earthlcd/Pi-RAQ/SolidWorks/MTL-15001-02-OSH.SLDPRT

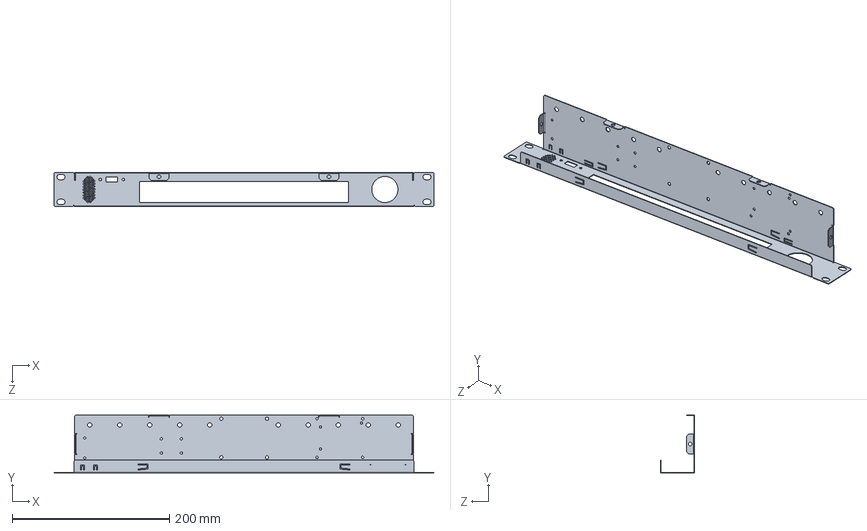
[picture p1: CAD file, 2015-07-02]
SolidWorks/MTL-15001-02-OSH.SLDPRT
482.6 x 73.7 x 43.7 mm
