earthlcd/Pi-RAQ/SolidWorks/MTL-15003-02-OSH.SLDPRT

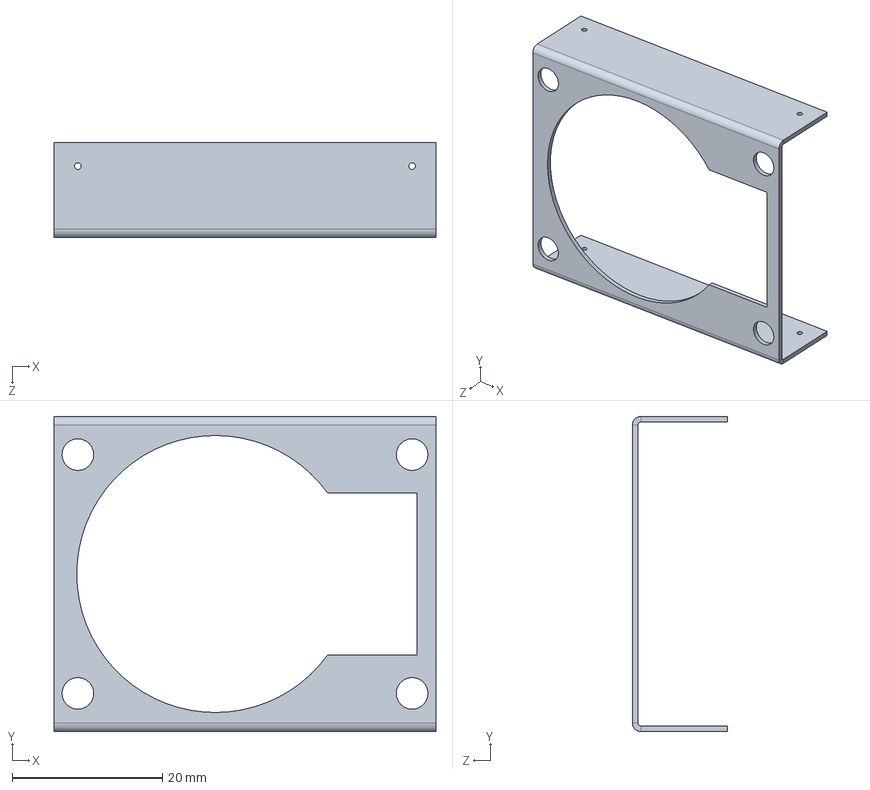
[picture p2: CAD file, 2015-07-02]
SolidWorks/MTL-15003-02-OSH.SLDPRT
50.8 x 41.9 x 12.7 mm
