earthlcd/Pi-RAQ/Altium/Schematic Prints.pdf

# LCD CONNECTOR

B0-7

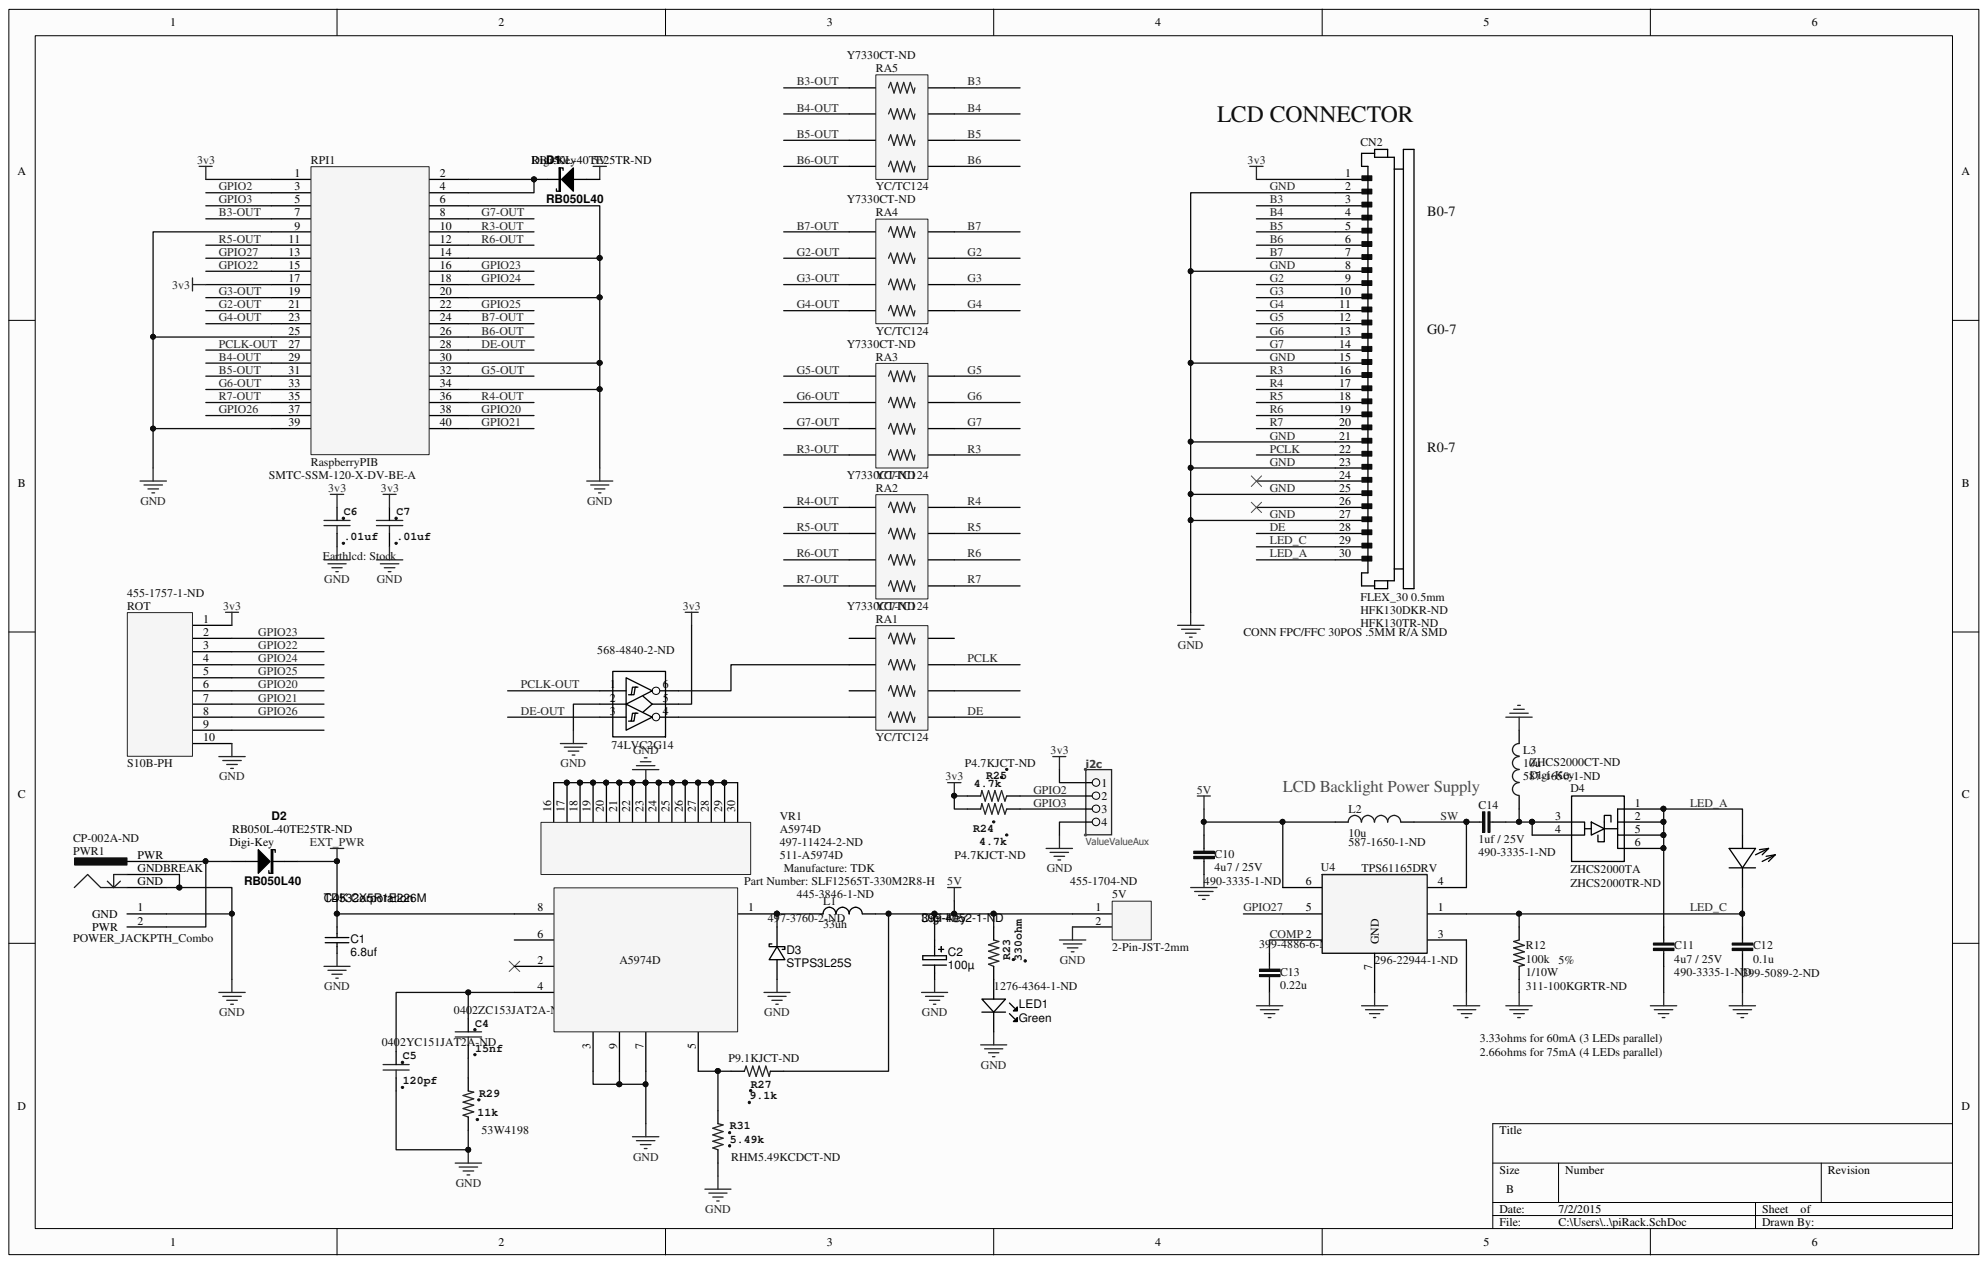
[picture p3: page 1]

SMTC-SSM-120-X-DV-BE-A

CONN FPC/FFC 30POS .5MM R/A SMD

LCD Backlight Power Supply
