earthlcd/Pi-RAQ/SolidWorks/MTL-15001-02-OSH.PDF

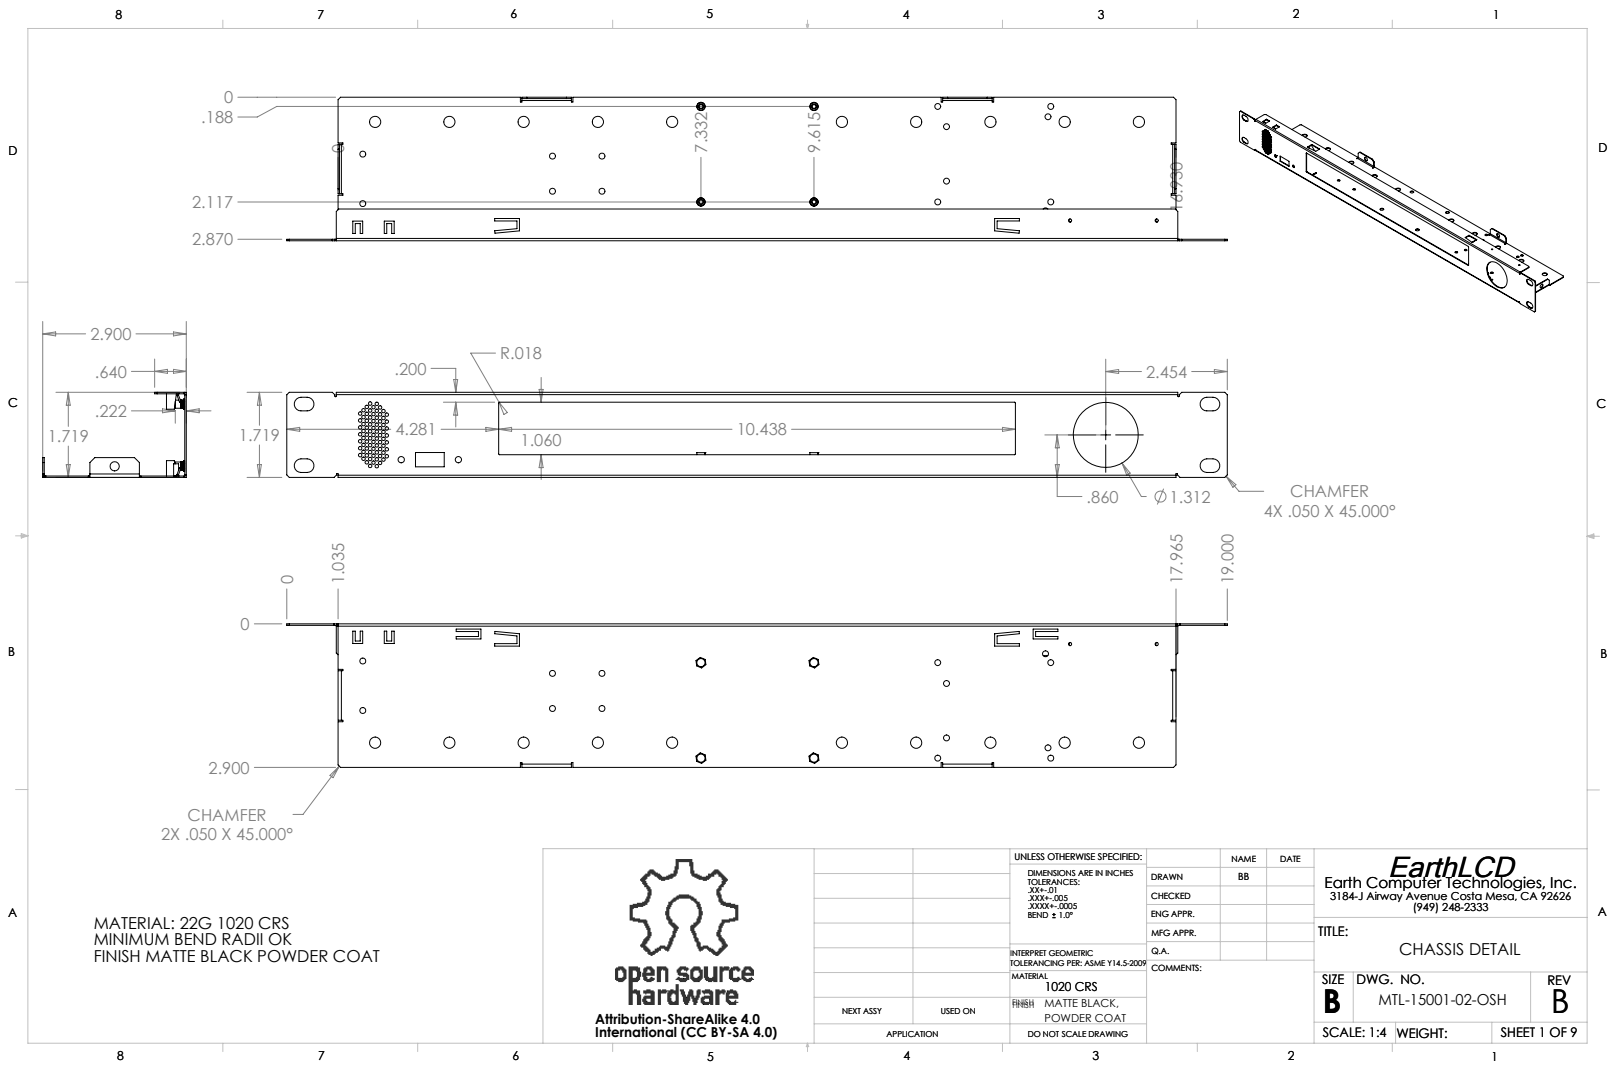
[picture p10: page 1]
FINISH MATTE BLACK POWDER COAT; CHASSIS DETAIL; NEXT ASSY; USED ON; ENG APPR.; MFG APPR.; DWG. NO.; REV; SCALE: 1:4 WEIGHT:; DO NOT SCALE DRAWING; SHEET 1 OF 9

EarthLCD
Earth Computer Technologies, Inc.
3184-J Airway Avenue Costa Mesa, CA 92626
TITLE:
MTL-15001-02-OSH

UNLESS OTHERWISE SPECIFIED:
DIMENSIONS ARE IN INCHES
TOLERANCES:
.XXX+-.005
.XXXX+-.0005
BEND 1.0°

MATERIAL: 22G 1020 CRS
MINIMUM BEND RADII OK

INTERPRET GEOMETRIC
TOLERANCING PER: ASME Y14.5-2009
MATERIAL
1020 CRS
MATTE BLACK,
FINISH
POWDER COAT
DO NOT SCALE DRAWING

Attribution-ShareAlike 4.0
International (CC BY-SA 4.0)

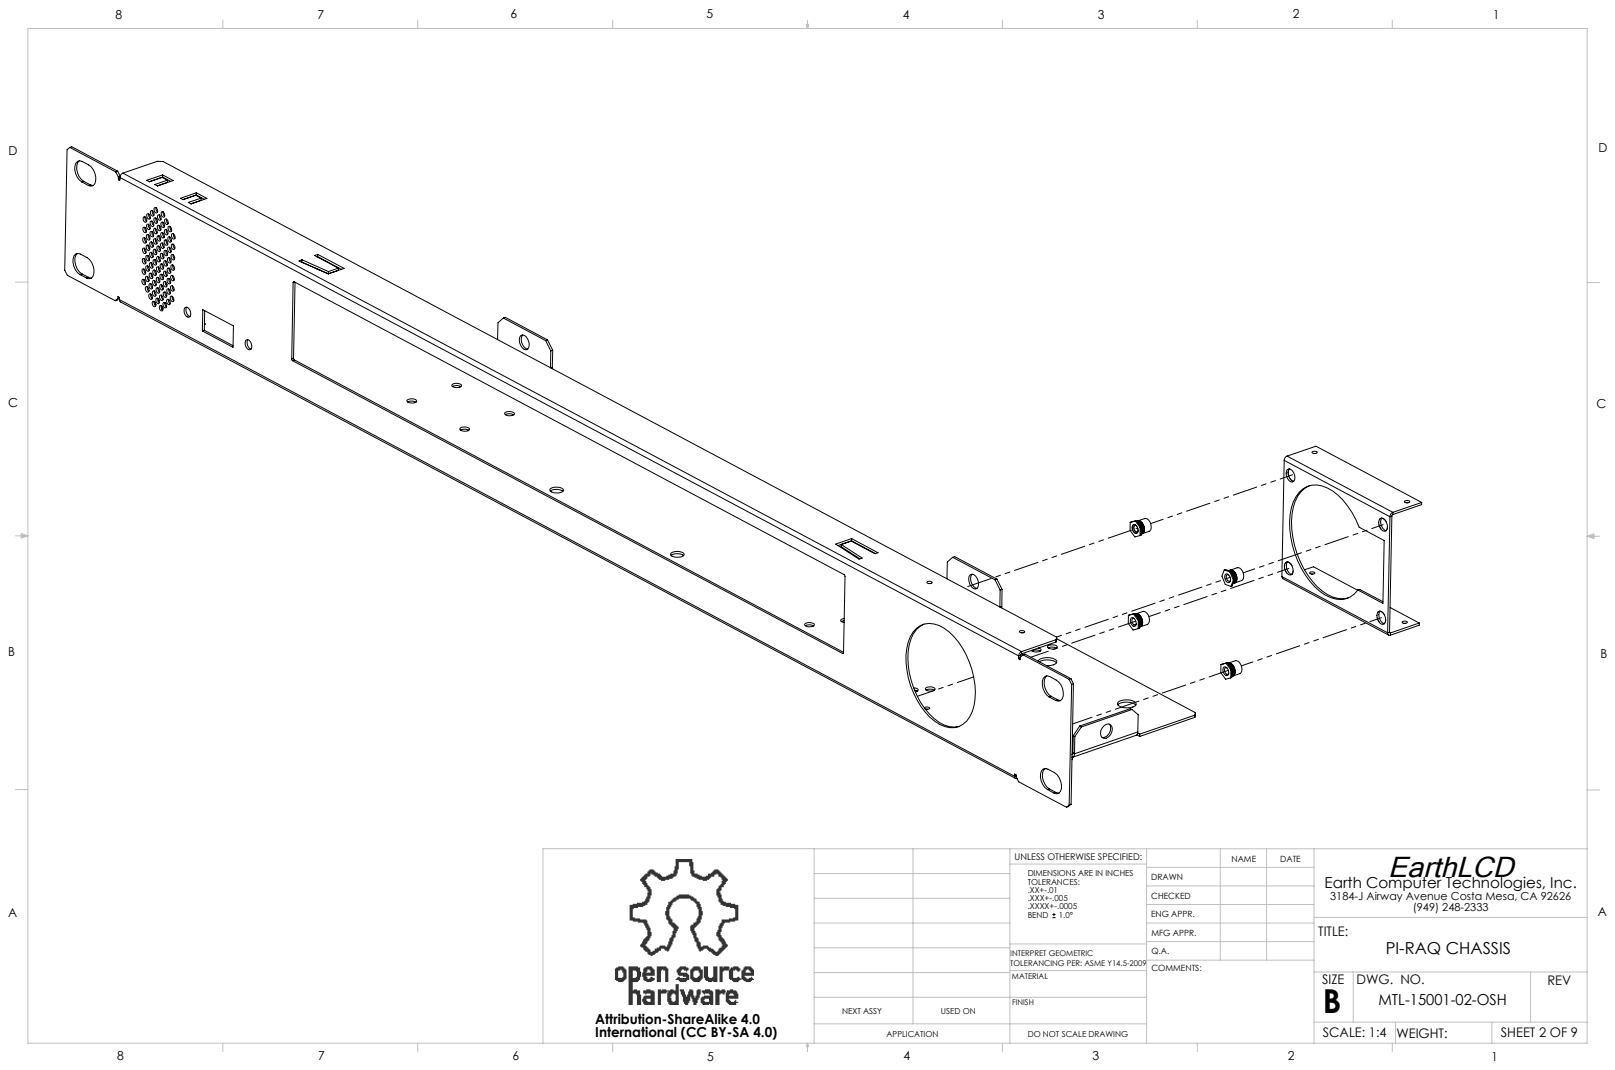
[picture p11: page 2]
ENG APPR.; MFG APPR.; DWG. NO.; REV

EarthLCD
Earth Computer Technologies, Inc.
3184-J Airway Avenue Costa Mesa, CA 92626
TITLE:
PI-RAQ CHASSIS

UNLESS OTHERWISE SPECIFIED:
DIMENSIONS ARE IN INCHES
TOLERANCES:
.XXX+-.005
.XXXX+-.0005
BEND 1.0°

INTERPRET GEOMETRIC
TOLERANCING PER: ASME Y14.5-2009
MATERIAL

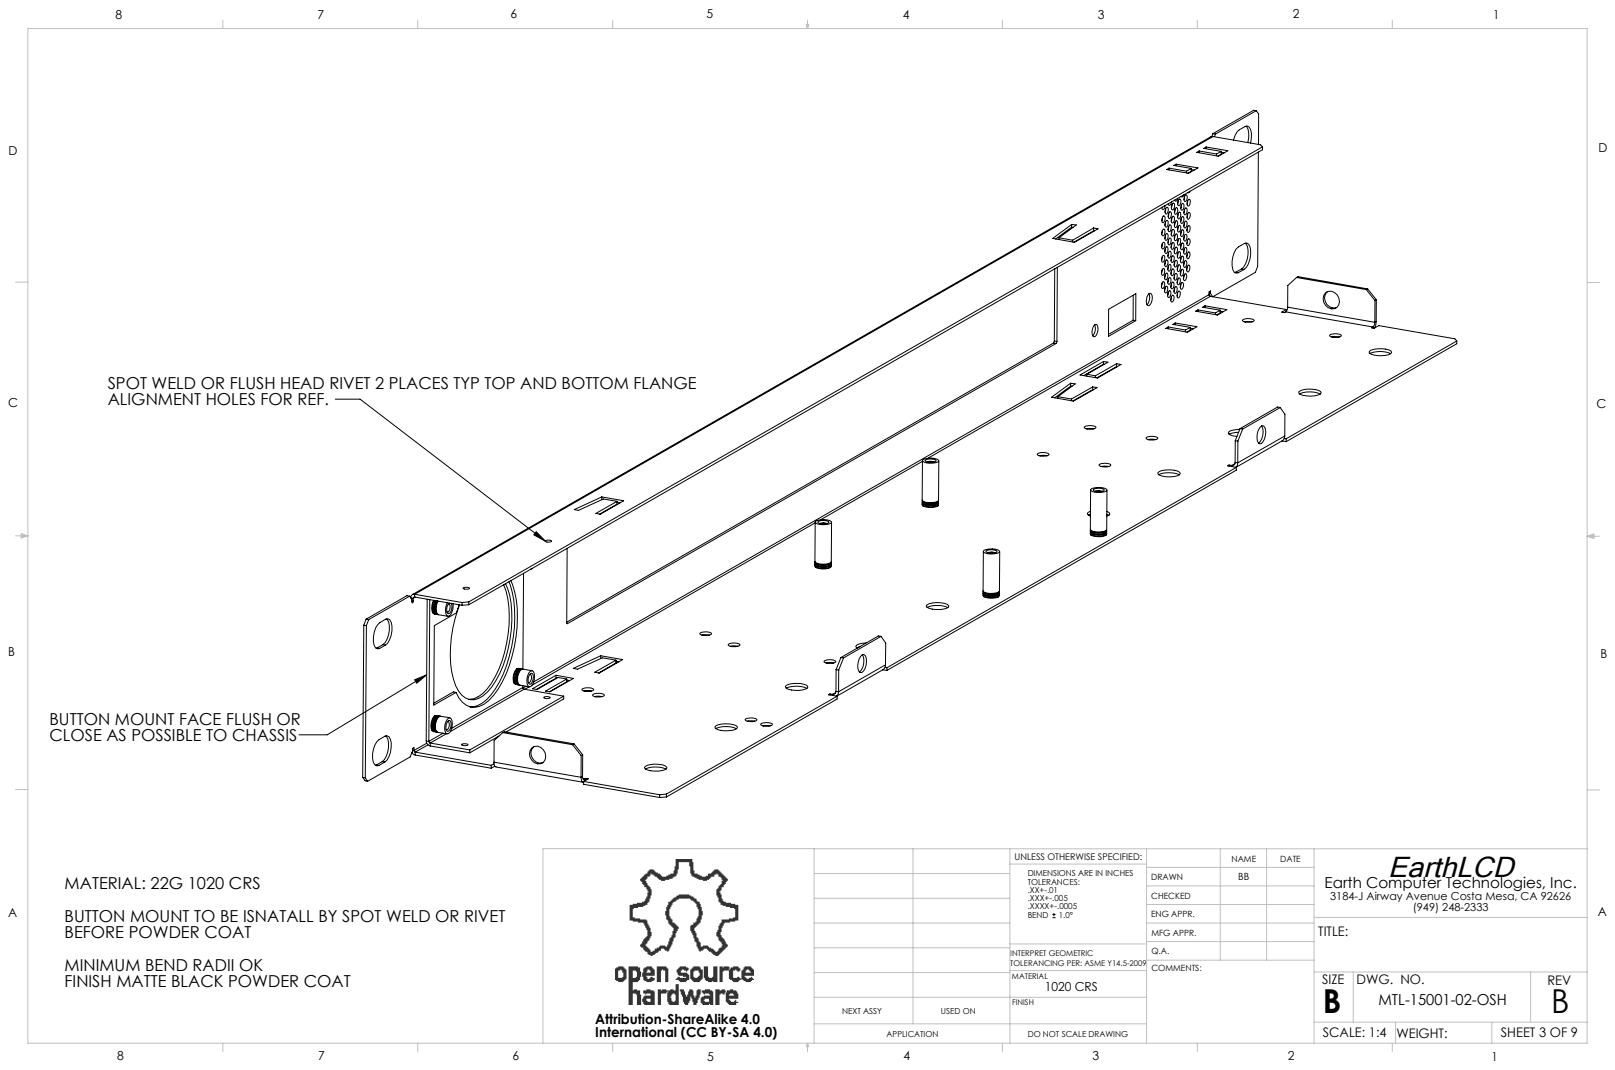
[picture p12: page 3]
ENG APPR.; MFG APPR.; DWG. NO.; REV

SPOT WELD OR FLUSH HEAD RIVET 2 PLACES TYP TOP AND BOTTOM FLANGE
ALIGNMENT HOLES FOR REF.

BUTTON MOUNT FACE FLUSH OR
CLOSE AS POSSIBLE TO CHASSIS

EarthLCD
Earth Computer Technologies, Inc.
3184-J Airway Avenue Costa Mesa, CA 92626
TITLE:

UNLESS OTHERWISE SPECIFIED:
DIMENSIONS ARE IN INCHES
TOLERANCES:
.XXX+-.005
.XXXX+-.0005
BEND 1.0°

MATERIAL: 22G 1020 CRS
BUTTON MOUNT TO BE ISNATALL BY SPOT WELD OR RIVET
BEFORE POWDER COAT
MINIMUM BEND RADII OK
FINISH MATTE BLACK POWDER COAT

INTERPRET GEOMETRIC
TOLERANCING PER: ASME Y14.5-2009
MATERIAL
1020 CRS

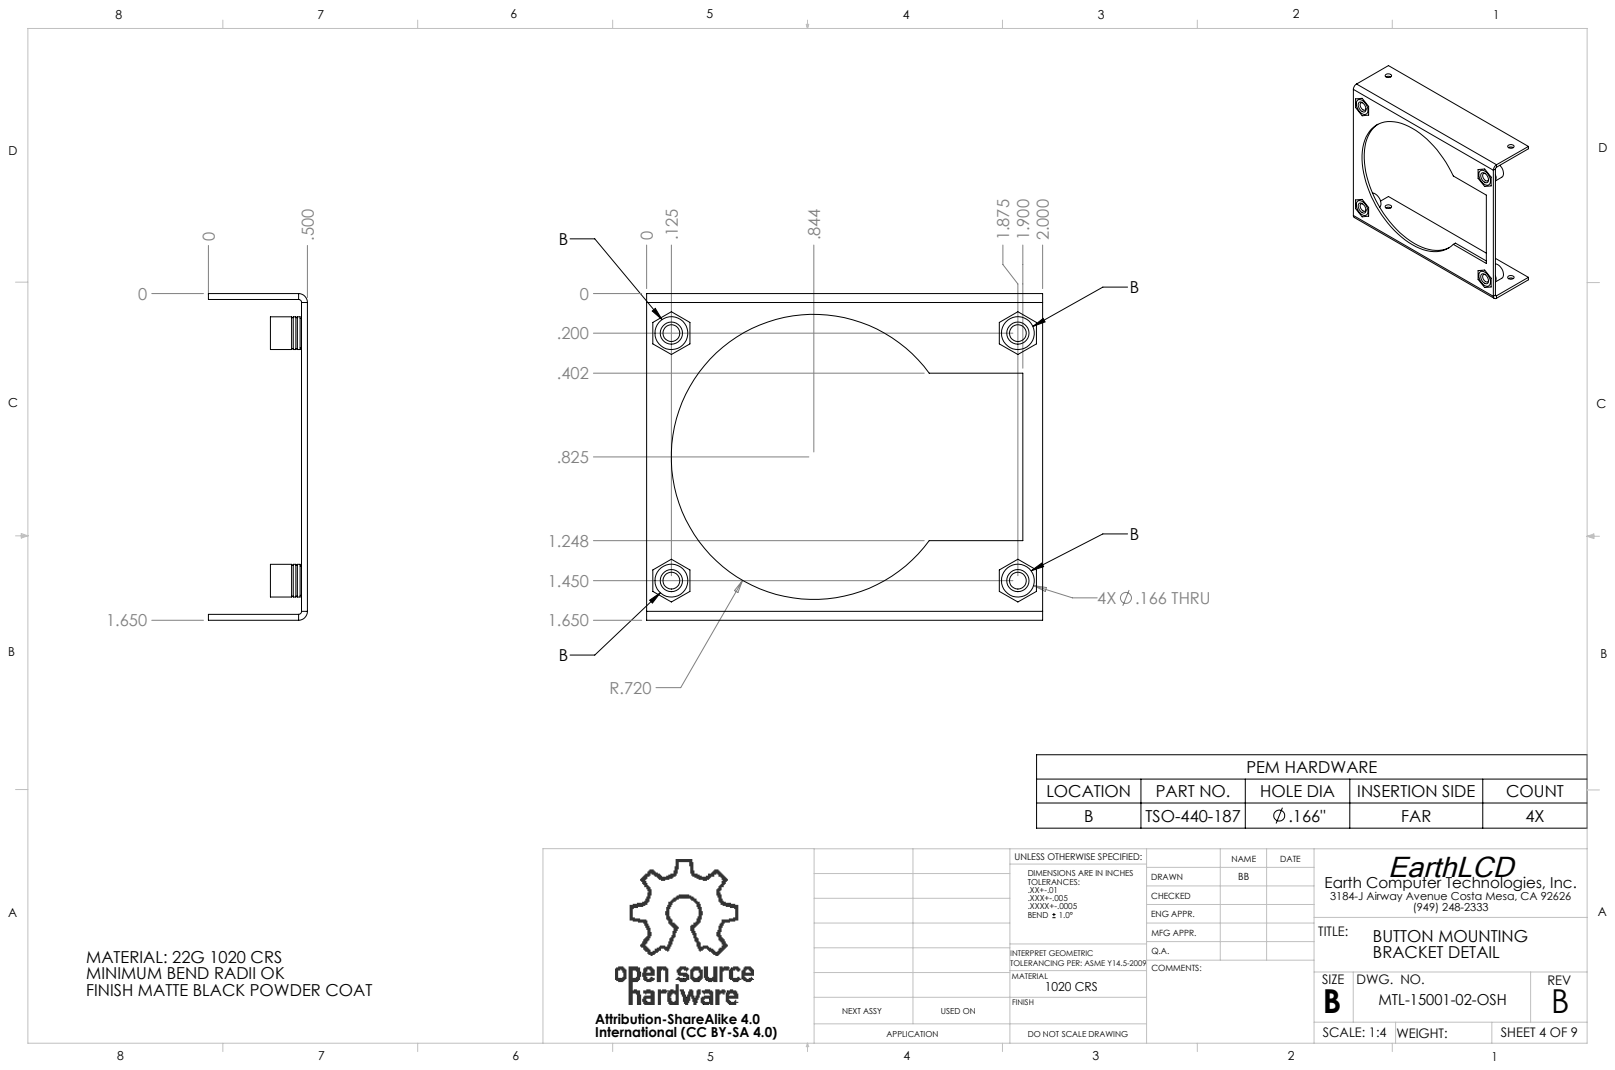
[picture p13: page 4]
4X .166 THRU; MATERIAL: 22G 1020 CRS; BRACKET DETAIL; ENG APPR.; MFG APPR.; DWG. NO.; REV

PEM HARDWARE
EarthLCD
Earth Computer Technologies, Inc.
3184-J Airway Avenue Costa Mesa, CA 92626
TITLE:
BUTTON MOUNTING

LOCATION | PART NO. | HOLE DIA | INSERTION SIDE | COUNT
B | TSO-440-187 | .166" | FAR | 4X

UNLESS OTHERWISE SPECIFIED:
DIMENSIONS ARE IN INCHES
TOLERANCES:
.XXX+-.005
.XXXX+-.0005
BEND 1.0°

MINIMUM BEND RADII OK
FINISH MATTE BLACK POWDER COAT

INTERPRET GEOMETRIC
TOLERANCING PER: ASME Y14.5-2009
MATERIAL
1020 CRS

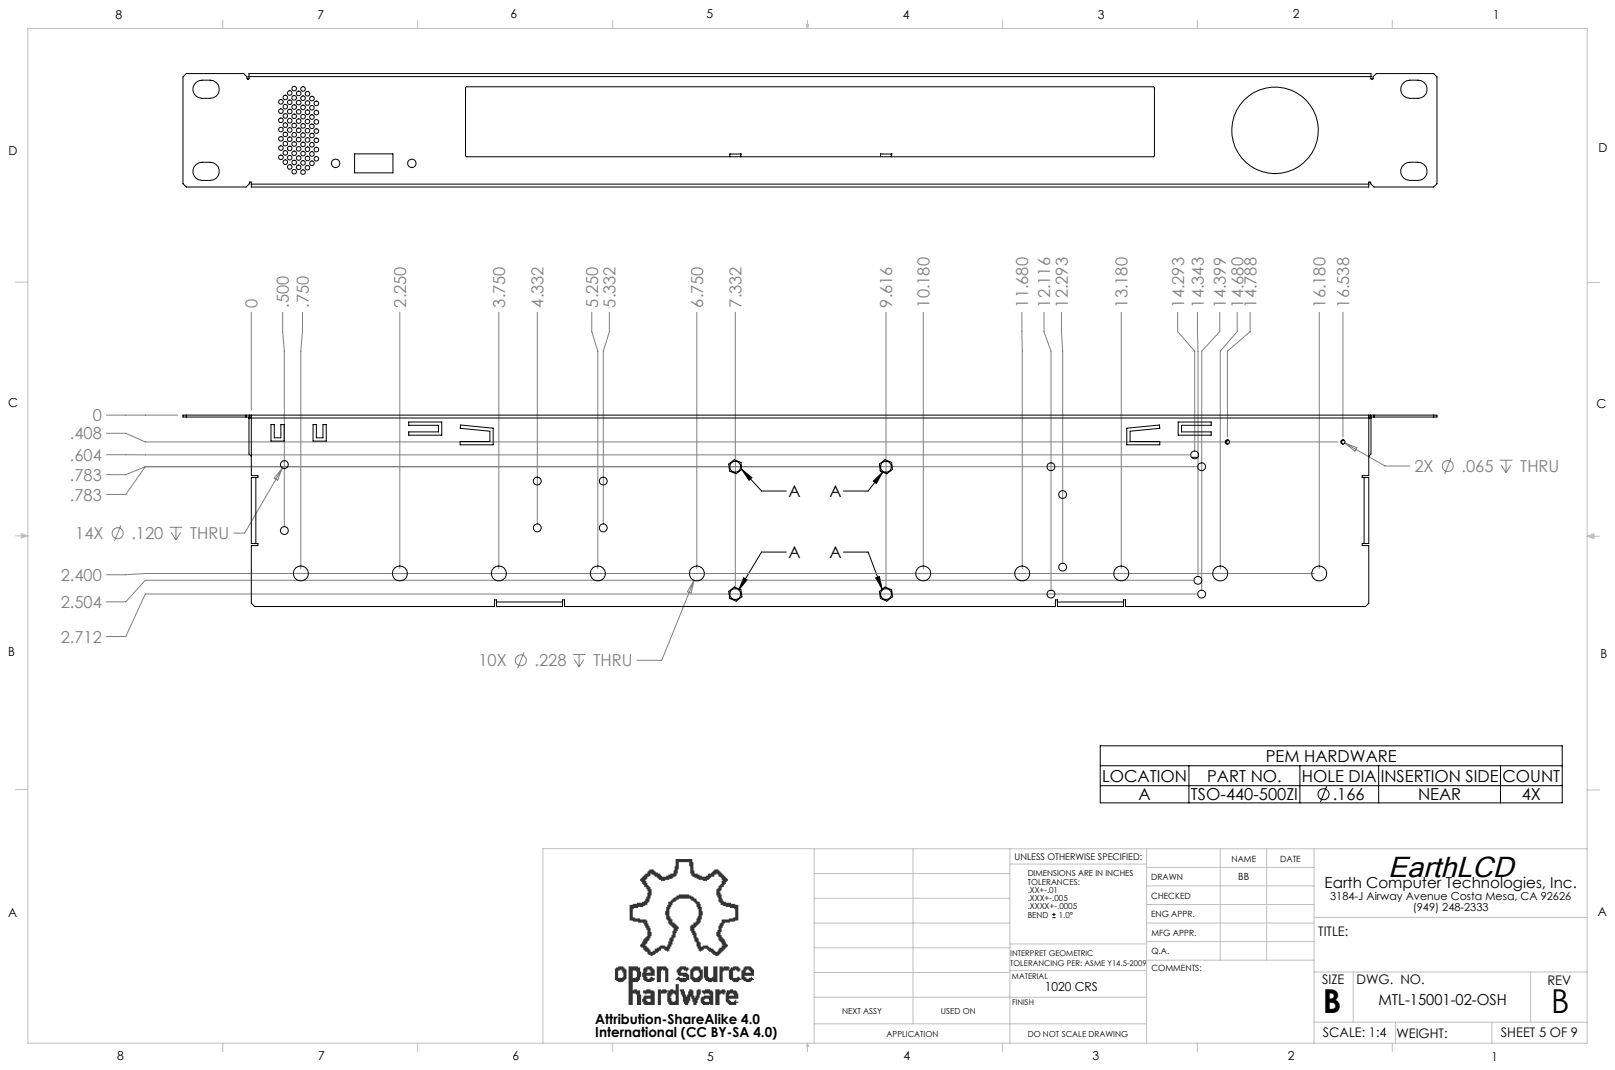
[picture p14: page 5]
.120 THRU; .228 THRU; .065 THRU; PEM HARDWARE; ENG APPR.; MFG APPR.; DWG. NO.; REV

LOCATION | PART NO. | HOLE DIA INSERTION SIDE COUNT
A | TSO-440-500ZI | .166 | NEAR | 4X

EarthLCD
Earth Computer Technologies, Inc.
3184-J Airway Avenue Costa Mesa, CA 92626
TITLE:

UNLESS OTHERWISE SPECIFIED:
DIMENSIONS ARE IN INCHES
TOLERANCES:
.XXX+-.005
.XXXX+-.0005
BEND 1.0°

INTERPRET GEOMETRIC
TOLERANCING PER: ASME Y14.5-2009
MATERIAL
1020 CRS

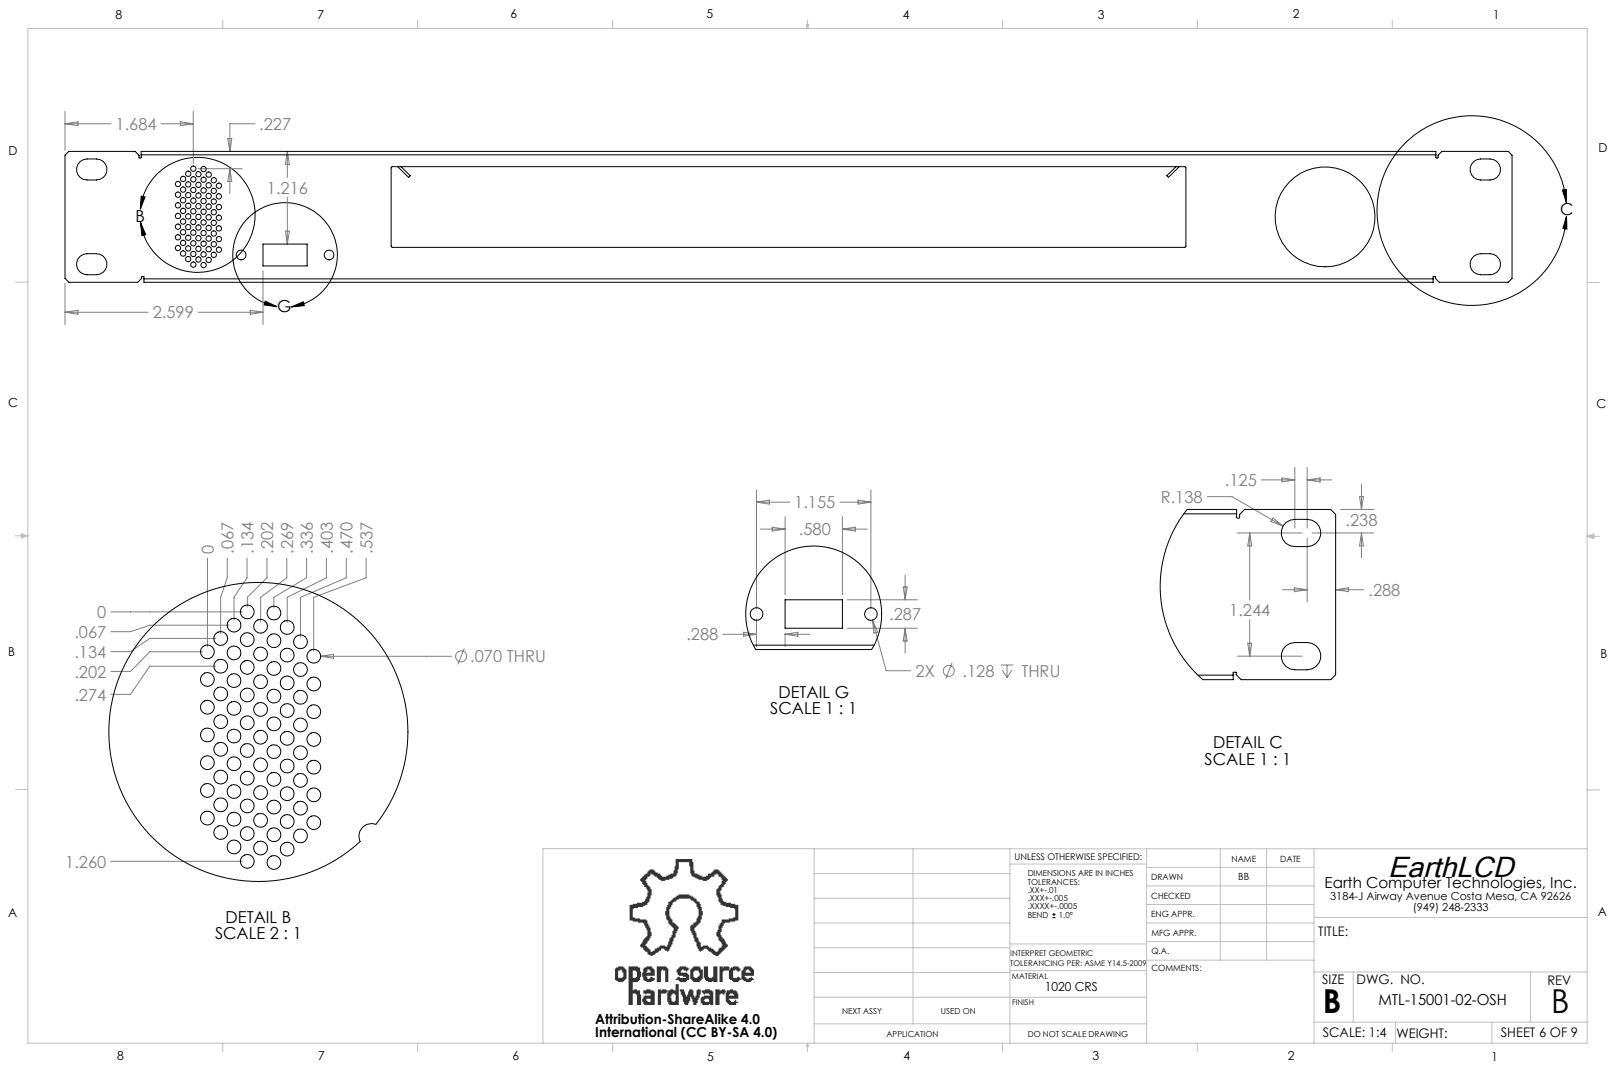
[picture p15: page 6]
.070 THRU; DETAIL B SCALE 2 : 1; DETAIL C SCALE 1 : 1; .128 THRU; DETAIL G SCALE 1 : 1; ENG APPR.; MFG APPR.; DWG. NO.; REV

EarthLCD
Earth Computer Technologies, Inc.
3184-J Airway Avenue Costa Mesa, CA 92626
TITLE:

UNLESS OTHERWISE SPECIFIED:
DIMENSIONS ARE IN INCHES
TOLERANCES:
.XXX+-.005
.XXXX+-.0005
BEND 1.0°

INTERPRET GEOMETRIC
TOLERANCING PER: ASME Y14.5-2009
MATERIAL
1020 CRS

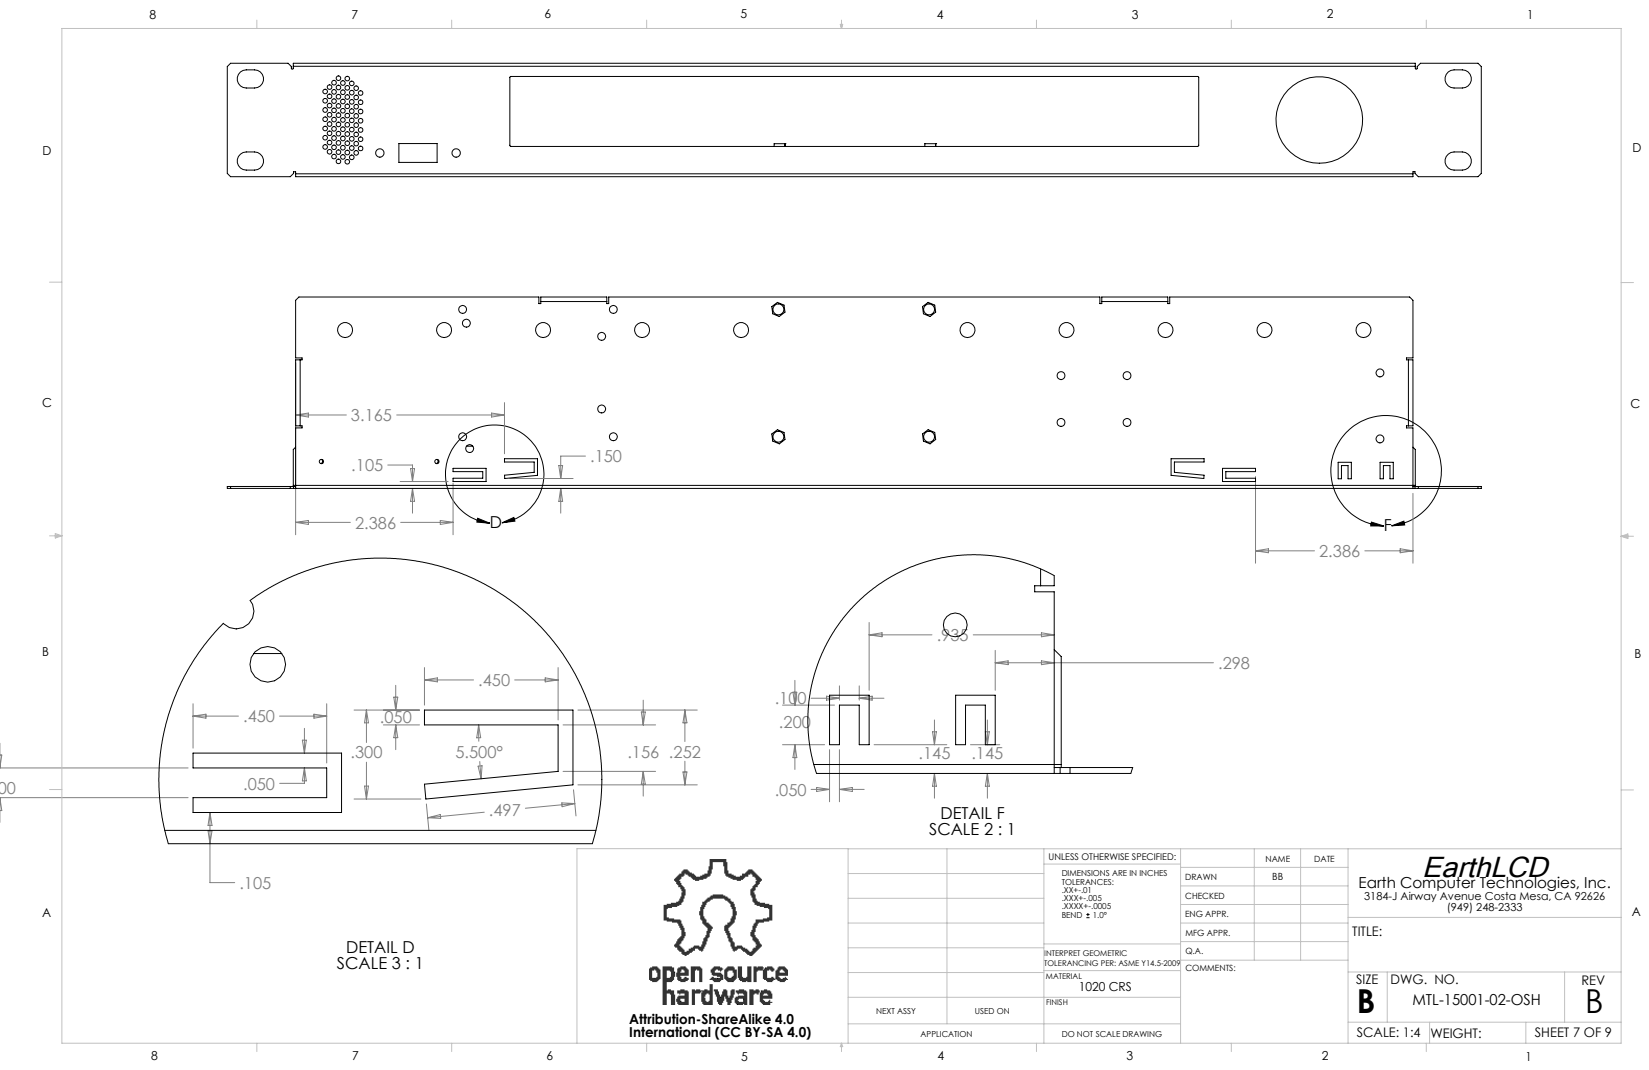
[picture p16: page 7]
DETAIL D SCALE 3 : 1; DETAIL F SCALE 2 : 1; ENG APPR.; MFG APPR.; DWG. NO.; REV

EarthLCD
Earth Computer Technologies, Inc.
3184-J Airway Avenue Costa Mesa, CA 92626
TITLE:

UNLESS OTHERWISE SPECIFIED:
DIMENSIONS ARE IN INCHES
TOLERANCES:
.XXX+-.005
.XXXX+-.0005
BEND 1.0°

INTERPRET GEOMETRIC
TOLERANCING PER: ASME Y14.5-2009
MATERIAL
1020 CRS

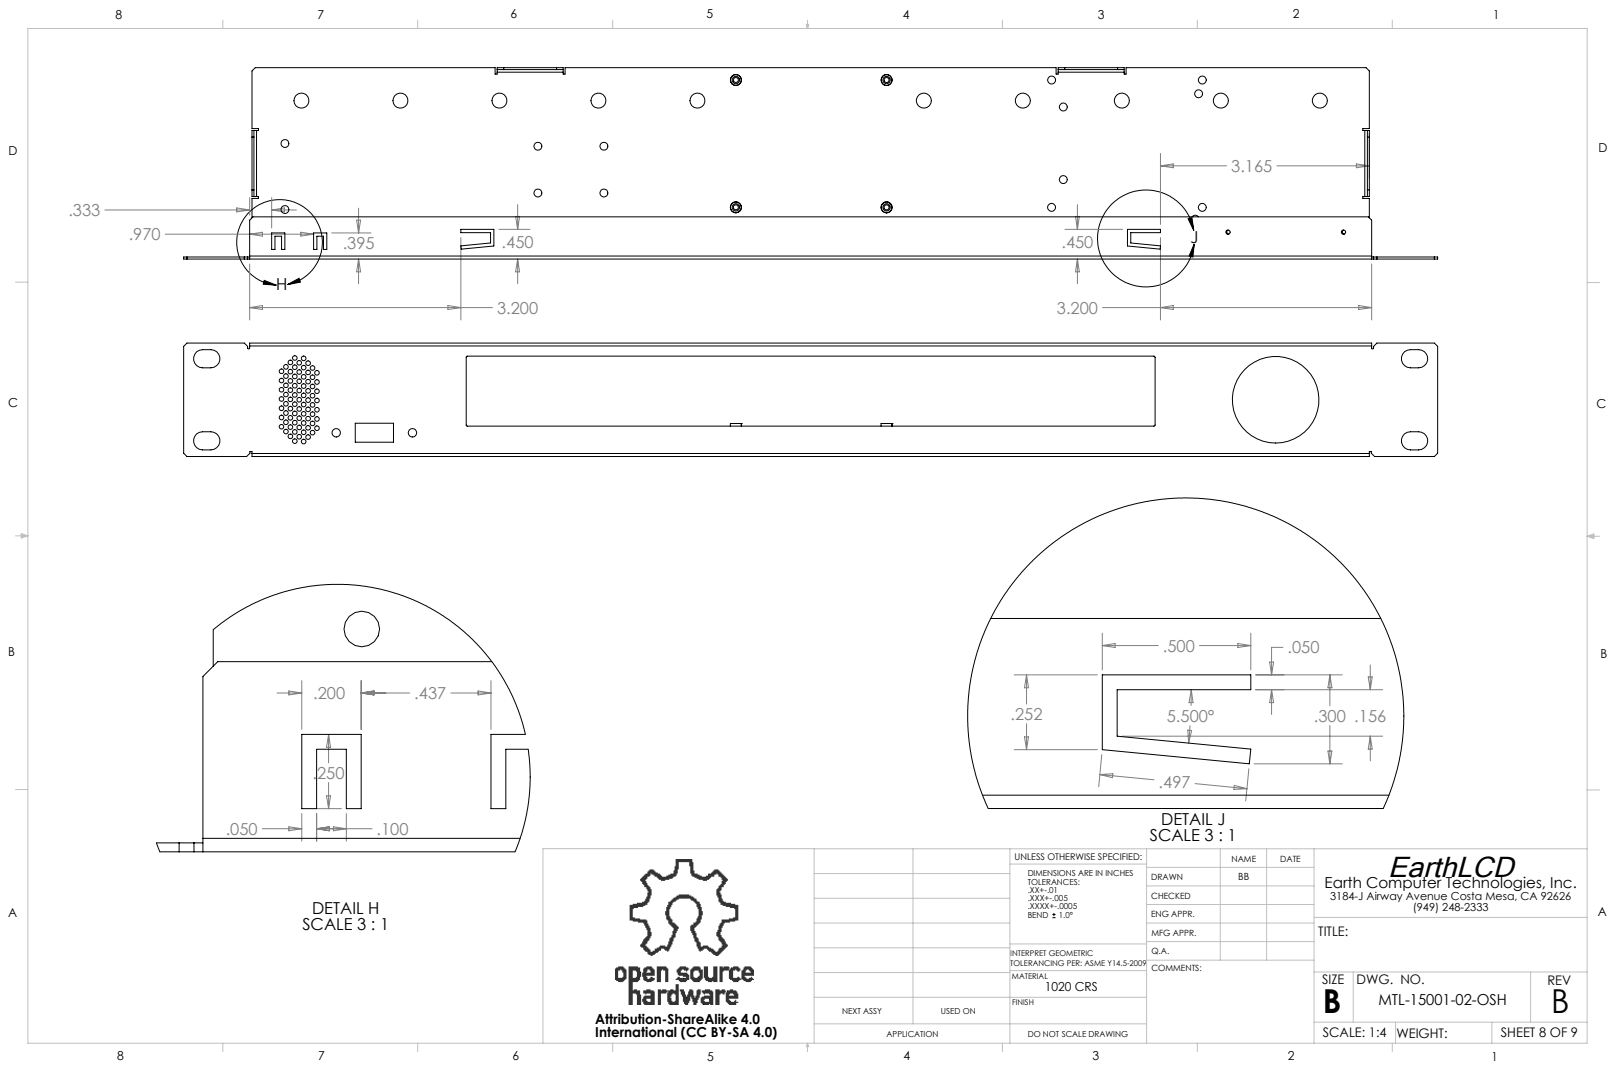
[picture p17: page 8]
DETAIL H SCALE 3 : 1; DETAIL J SCALE 3 : 1; ENG APPR.; MFG APPR.; DWG. NO.; REV

EarthLCD
Earth Computer Technologies, Inc.
3184-J Airway Avenue Costa Mesa, CA 92626
TITLE:

UNLESS OTHERWISE SPECIFIED:
DIMENSIONS ARE IN INCHES
TOLERANCES:
.XXX+-.005
.XXXX+-.0005
BEND 1.0°

INTERPRET GEOMETRIC
TOLERANCING PER: ASME Y14.5-2009
MATERIAL
1020 CRS

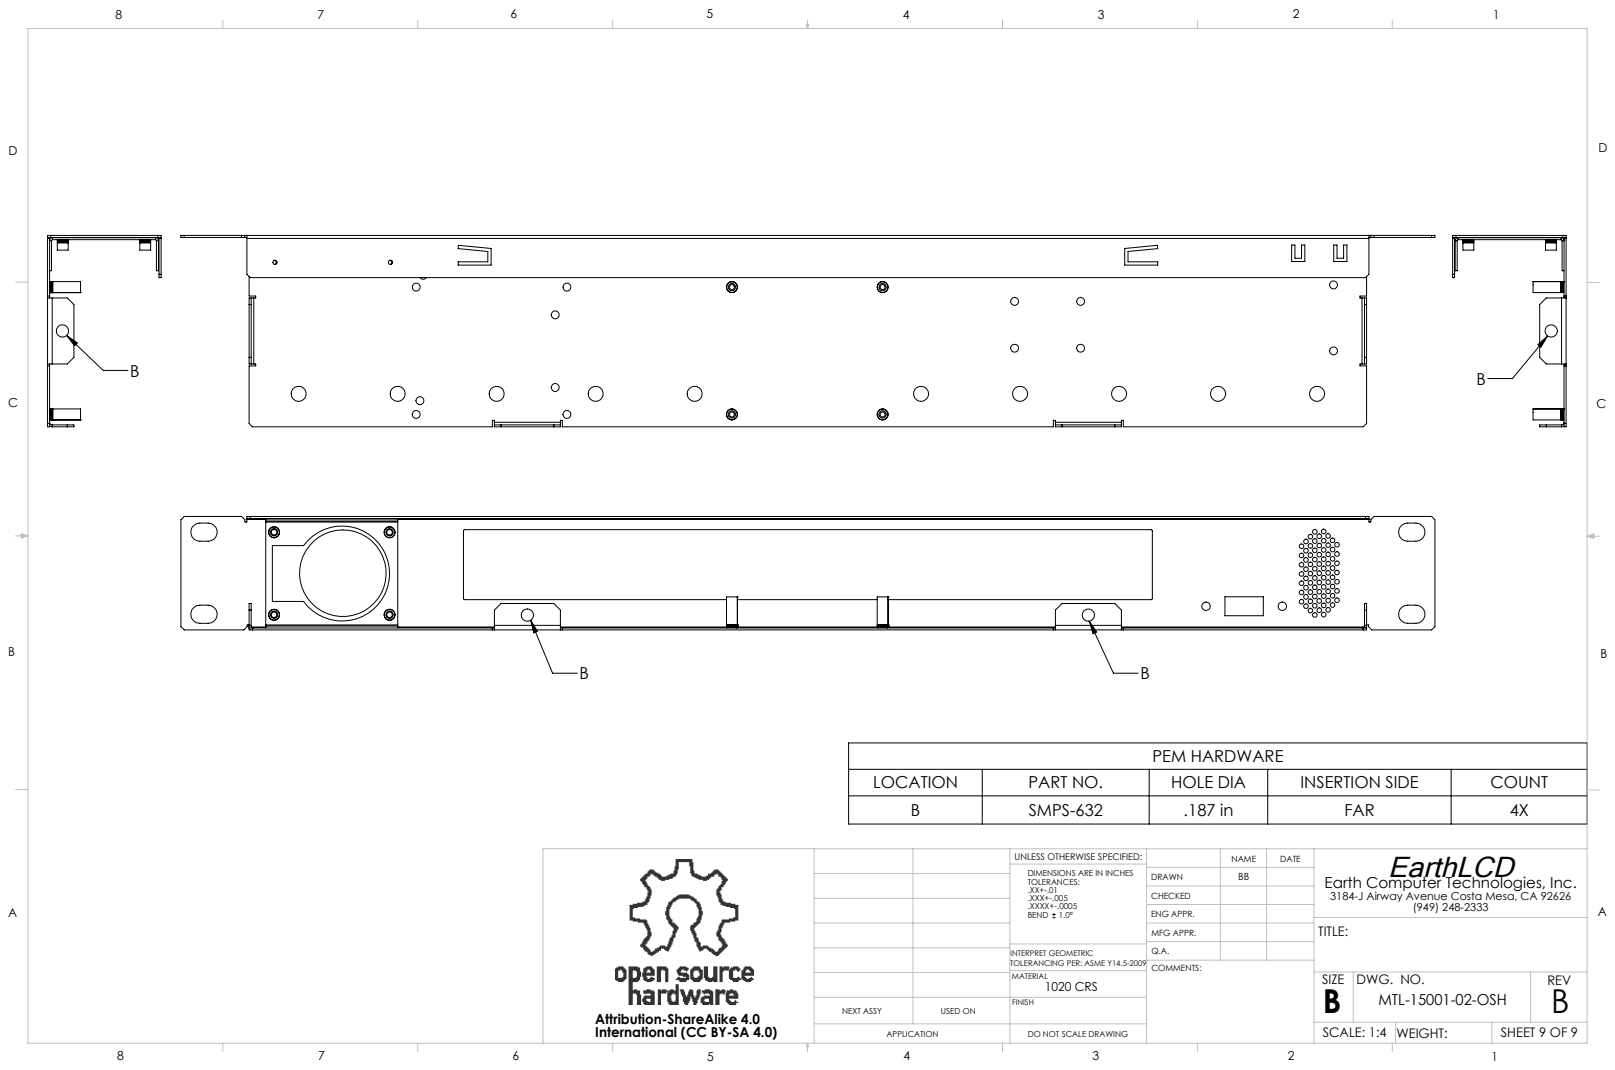
[picture p18: page 9]
PEM HARDWARE; ENG APPR.; MFG APPR.; DWG. NO.; REV

LOCATION | PART NO. | HOLE DIA | INSERTION SIDE | COUNT
B | SMPS-632 | .187 in | FAR | 4X

EarthLCD
Earth Computer Technologies, Inc.
3184-J Airway Avenue Costa Mesa, CA 92626
TITLE:

UNLESS OTHERWISE SPECIFIED:
DIMENSIONS ARE IN INCHES
TOLERANCES:
.XXX+-.005
.XXXX+-.0005
BEND 1.0°

INTERPRET GEOMETRIC
TOLERANCING PER: ASME Y14.5-2009
MATERIAL
1020 CRS
