earthlcd/Pi-RAQ/(list of files, drawings)

Other design files:
Altium/PIrack/piRack1.PcbLib
Altium/PIrack/piRack.PcbDoc
Altium/PIrack/piRack.PcbLib
Altium/PIrack/piRack.PrjPCB
Altium/PIrack/piRack.SchDoc
Altium/PIrack/piRack.SCHLIB
Altium/RotBoard/rotboard.PcbDoc
Altium/RotBoard/RotBoard.PrjPcb
Altium/RotBoard/rotboard.SchDoc
